lykoszczan/Gietarka_Arduino/README.md

# Gietarka_Arduino

Bachelor thesis - Implementation of the controller of the heating unit of the bending station for thermoplastic materials.

See [bachelor thesis file](https://github.com/lykoszczan/Gietarka_Arduino/blob/master/MT_1ST_278279.pdf)
