lykoszczan/Gietarka_Arduino/(commit log)

2018-12-13 Dodanie obsługi algorytmu PID
2019-01-11 Dodadnie obsługi drugiego czujnika temperatury
